Tuetuopay/stm32-usb-ble-devkit/README.md

# STM32 + nRF51 USB & BLE devkit

Small devkit to work with both USB and BLE. Useful for USB Bluetooth gadgets.
