Tuetuopay/stm32-usb-ble-devkit/pcb/stm32-usb-ble-devkit.brd

## EAGLE design pcb/stm32-usb-ble-devkit.brd (2018-11-05)

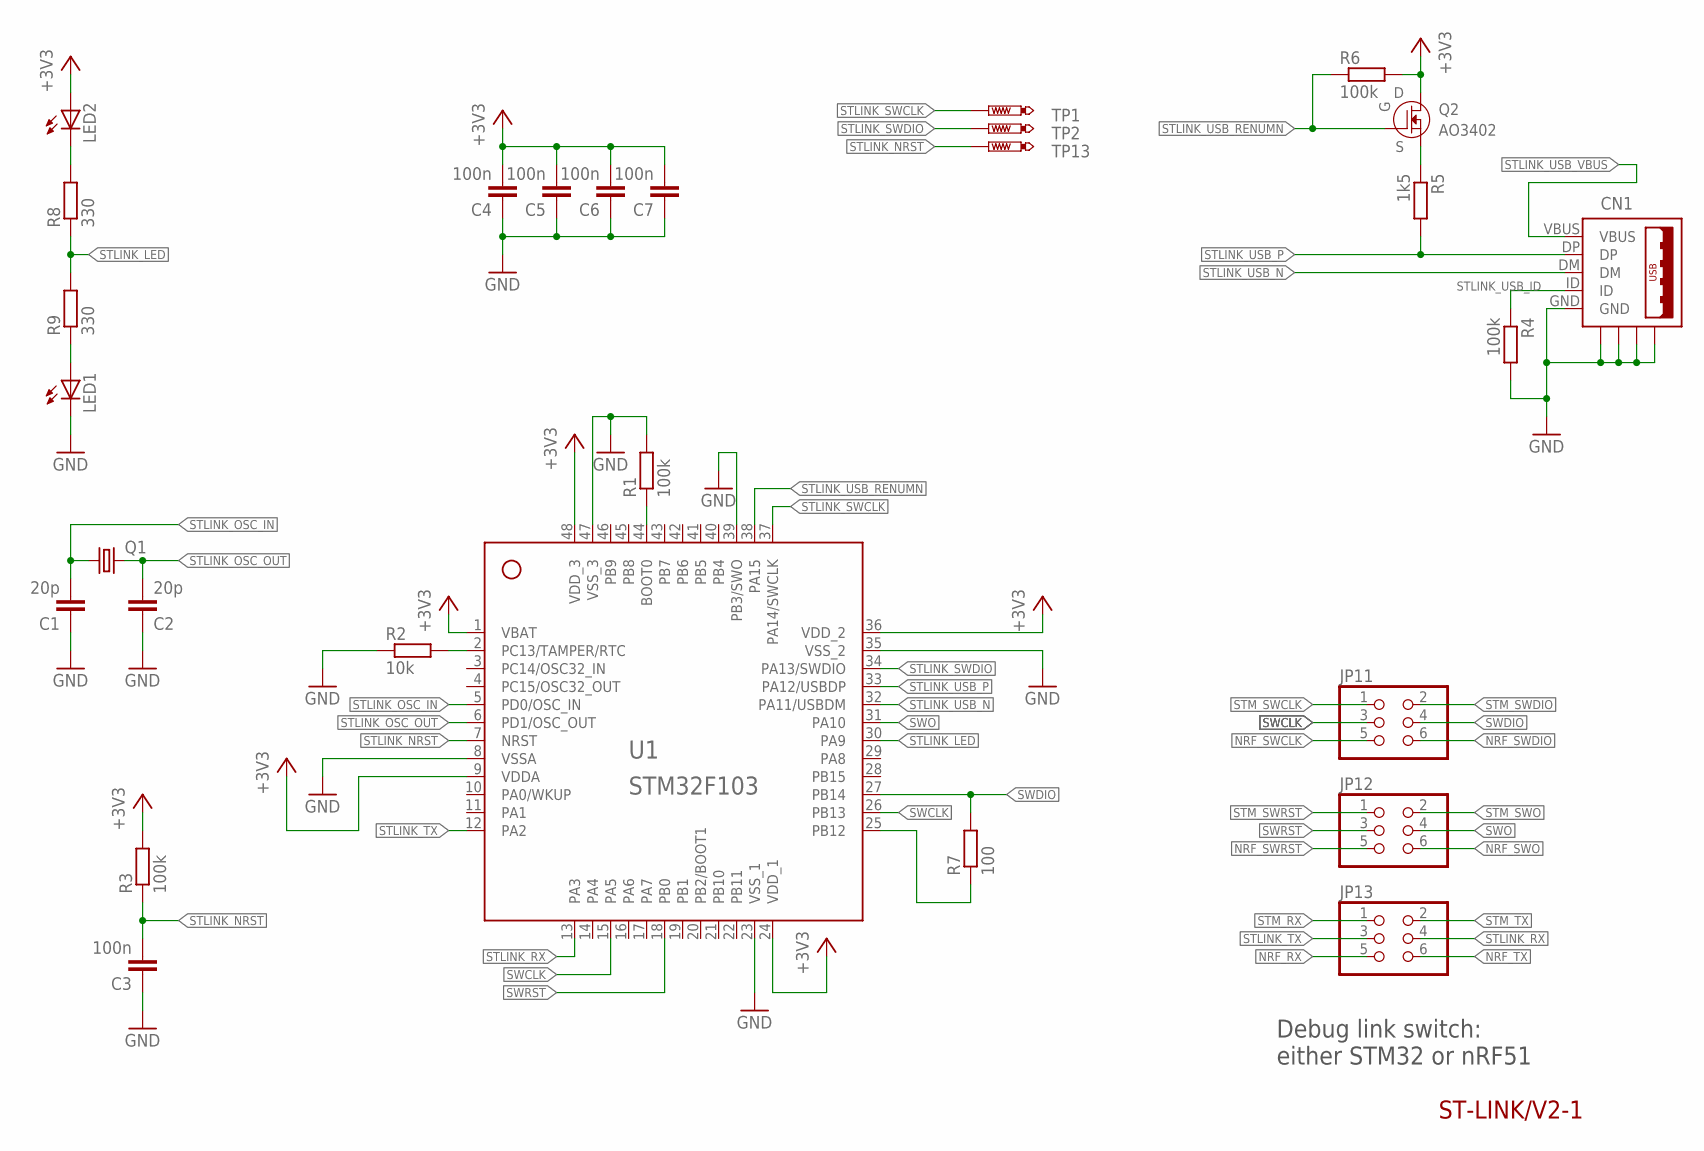
[picture p1: schematic stm32-usb-ble-devkit.sch, sheet 1]

Parts:
C1, C2: 20p; 0603
C3, C4, C5, C6, C7: 100n; 0603
CN1: USB-MICROB-2TABS; USB-MICROB-2
JP11, JP12, JP13: PINHD-2X3; 2X03
LED1, LED2: LEDCHIP-LED0603; CHIP-LED0603
Q1: CRYSTALHC49S; HC49/S
Q2: AO3402; SOT23-3
R1, R3, R4, R6: 100k; R0603
R2: 10k; R0603
R5: 1k5; R0603
R7: 100; R0603
R8, R9: 330; R0603
TP1, TP2, TP13: PTR1B1,27; B1,27
U1: STM32F103-48LQFP; LQFP-48

Connections:
+3V3: C4.2, C5.2, C6.2, C7.2, LED2.A, Q2.3 (D), R3.2, R6.2, U1.1 (VBAT), U1.9 (VDDA), U1.24 (VDD_1), U1.36 (VDD_2), U1.48 (VDD_3); also elsewhere on the board
GND: C1.1, C2.1, C3.1, C4.1, C5.1, C6.1, C7.1, CN1.GND, CN1.GND@1 (GND), CN1.GND@2 (GND), CN1.GND@3 (GND), CN1.GND@4 (GND), LED1.C, R1.2, R2.1, R4.2, U1.8 (VSSA), U1.23 (VSS_1), U1.35 (VSS_2), U1.39 (PB3/SWO), U1.47 (VSS_3); also elsewhere on the board
NRF_RX: JP13.5; also elsewhere on the board
NRF_SWCLK: JP11.5; also elsewhere on the board
NRF_SWDIO: JP11.6; also elsewhere on the board
NRF_SWO: JP12.6
NRF_SWRST: JP12.5
NRF_TX: JP13.6; also elsewhere on the board
STLINK_BOOT0: R1.1, U1.44 (BOOT0)
STLINK_LED: R8.1, R9.2, U1.30 (PA9)
STLINK_LED_RB: LED1.A, R9.1
STLINK_LED_RT: LED2.C, R8.2
STLINK_NRST: C3.2, R3.1, TP13.TP, U1.7 (NRST)
STLINK_OSC_IN: C1.2, Q1.1, U1.5 (PD0/OSC_IN)
STLINK_OSC_OUT: C2.2, Q1.2, U1.6 (PD1/OSC_OUT)
STLINK_PC13: R2.2, U1.2 (PC13/TAMPER/RTC)
STLINK_RX: JP13.4, U1.13 (PA3)
STLINK_SWCLK: TP1.TP, U1.37 (PA14/SWCLK)
STLINK_SWDIO: TP2.TP, U1.34 (PA13/SWDIO)
STLINK_SWDIO_PD: R7.1, U1.25 (PB12)
STLINK_TX: JP13.3, U1.12 (PA2)
STLINK_USB_ID: CN1.ID, R4.1
STLINK_USB_N: CN1.DM, U1.32 (PA11/USBDM)
STLINK_USB_P: CN1.DP, R5.2, U1.33 (PA12/USBDP)
STLINK_USB_RENUMN: Q2.1 (G), R6.1, U1.38 (PA15)
STLINK_USB_RENUM_PU: Q2.2 (S), R5.1
STLINK_USB_VBUS: CN1.VBUS; also elsewhere on the board
STM_RX: JP13.1; also elsewhere on the board
STM_SWCLK: JP11.1; also elsewhere on the board
STM_SWDIO: JP11.2; also elsewhere on the board
STM_SWO: JP12.2; also elsewhere on the board
STM_SWRST: JP12.1; also elsewhere on the board
STM_TX: JP13.2; also elsewhere on the board
SWCLK: JP11.3, U1.15 (PA5), U1.26 (PB13)
SWDIO: JP11.4, R7.2, U1.27 (PB14)
SWO: JP12.4, U1.31 (PA10)
SWRST: JP12.3, U1.18 (PB0)

Notes on the sheet:
ST-LINK/V2-1
Debug link switch: either STM32 or nRF51

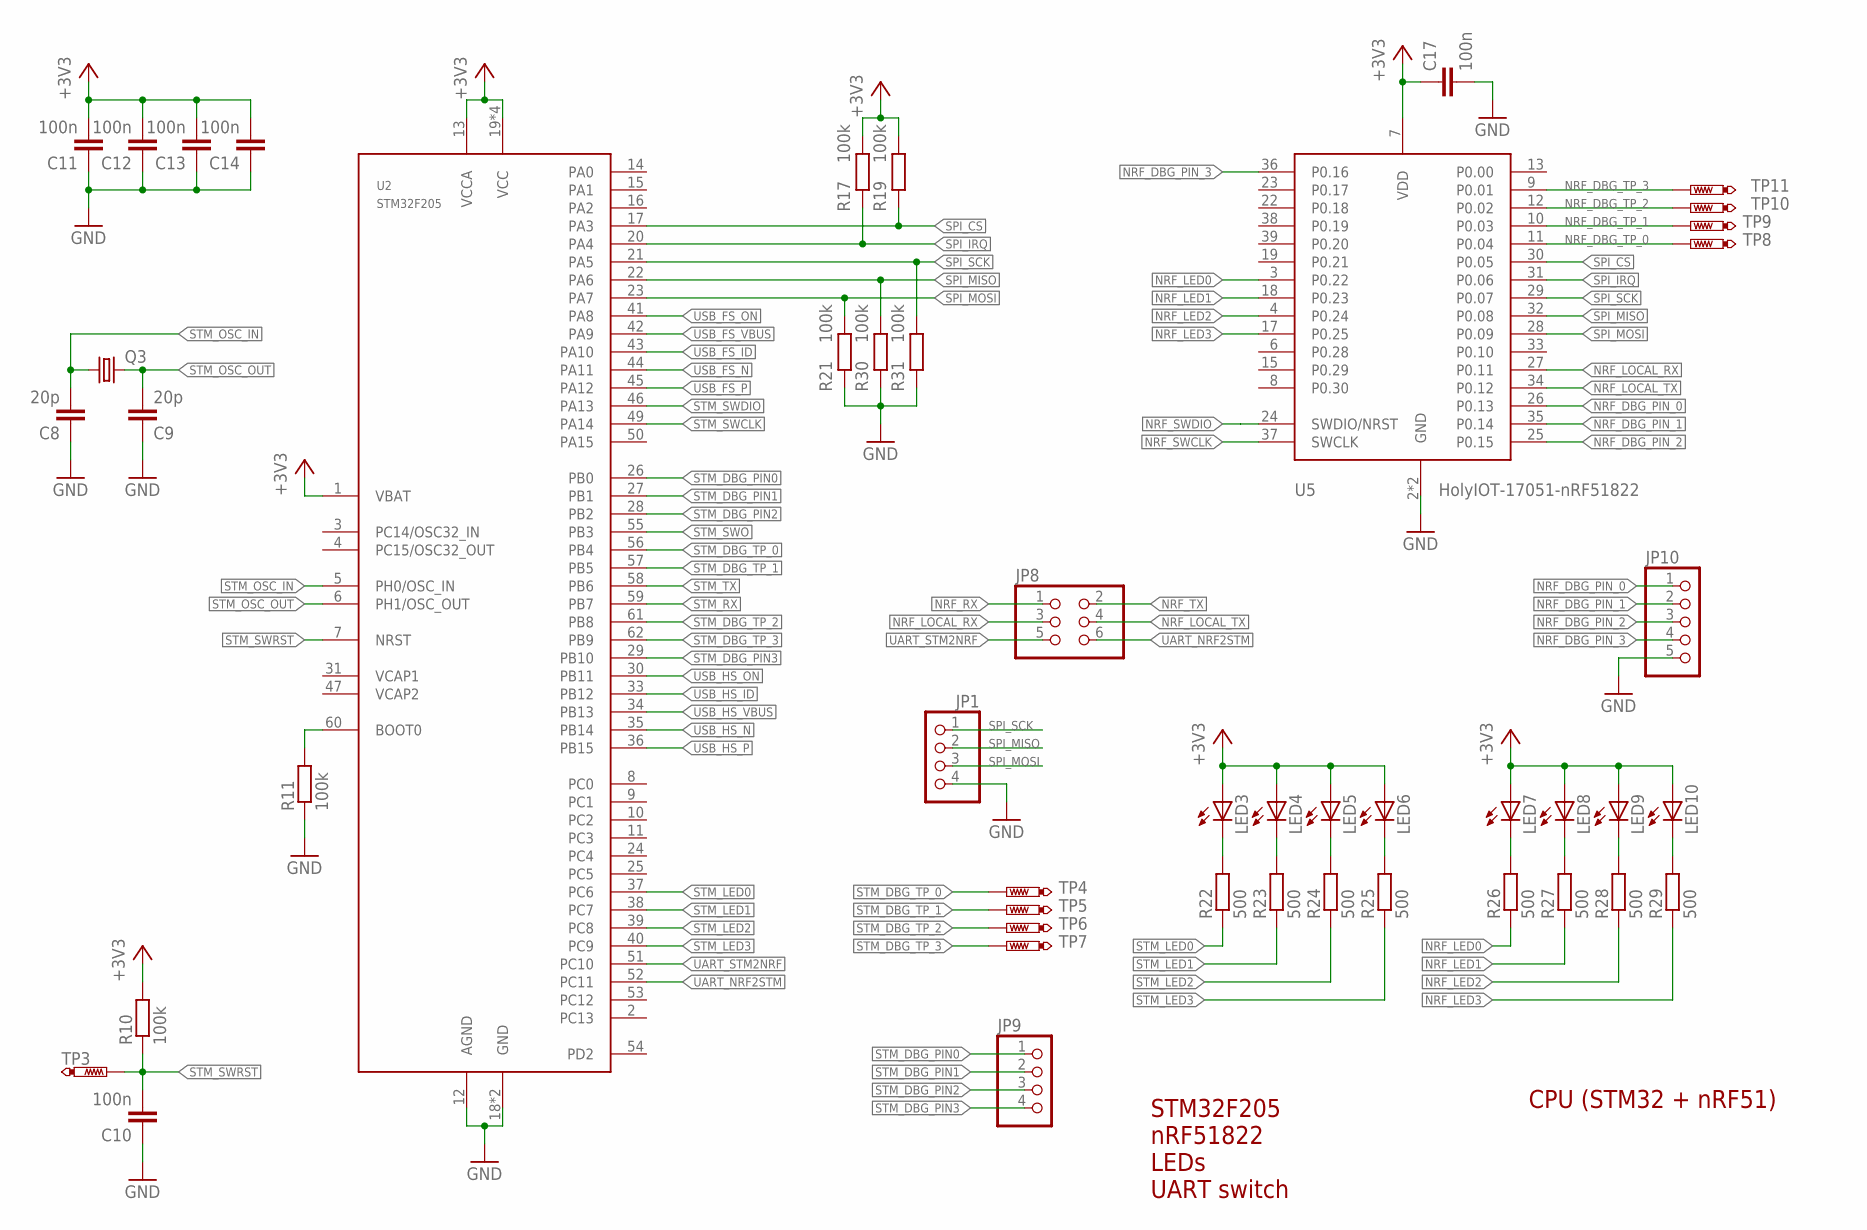
[picture p2: schematic stm32-usb-ble-devkit.sch, sheet 2]

Parts:
C8, C9: 20p; 0603
C10, C11, C12, C13, C14, C17: 100n; 0603
JP1, JP9: PINHD-1X4; 1X04
JP8: PINHD-2X3; 2X03
JP10: PINHD-1X5; 1X05
LED3, LED4, LED5, LED6, LED7, LED8, LED9, LED10: LEDCHIP-LED0603; CHIP-LED0603
Q3: CRYSTALHC49S; HC49/S
R10, R11, R17, R19, R21, R30, R31: 100k; R0603
R22, R23, R24, R25, R26, R27, R28, R29: 500; R0603
TP3, TP4, TP5, TP6, TP7, TP8, TP9, TP10, TP11: PTR1B1,27; B1,27
U2: STM32F205-64; LQFP-64
U5: HOLYIOT-17051-NRF51822

Connections:
+3V3: C11.2, C12.2, C13.2, C14.2, C17.1, LED3.A, LED4.A, LED5.A, LED6.A, LED7.A, LED8.A, LED9.A, LED10.A, R10.2, R17.2, R19.2, U2.1 (VBAT), U2.13 (VCCA), U2.19 (VCC), U2.32 (VCC), U2.48 (VCC), U2.64 (VCC), U5.7 (VDD); also elsewhere on the board
BOOT0: R11.2, U2.60 (BOOT0)
GND: C8.1, C9.1, C10.1, C11.1, C12.1, C13.1, C14.1, C17.2, JP1.4, JP10.5, R11.1, R21.1, R30.1, R31.1, U2.12 (AGND), U2.18 (GND), U2.63 (GND), U5.2 (GND), U5.14 (GND); also elsewhere on the board
NRF_DBG_PIN_0: JP10.1, U5.26 (P0.13)
NRF_DBG_PIN_1: JP10.2, U5.35 (P0.14)
NRF_DBG_PIN_2: JP10.3, U5.25 (P0.15)
NRF_DBG_PIN_3: JP10.4, U5.36 (P0.16)
NRF_DBG_TP_0: TP8.TP, U5.11 (P0.04)
NRF_DBG_TP_1: TP9.TP, U5.10 (P0.03)
NRF_DBG_TP_2: TP10.TP, U5.12 (P0.02)
NRF_DBG_TP_3: TP11.TP, U5.9 (P0.01)
NRF_LED0: R26.1, U5.3 (P0.22)
NRF_LED1: R27.1, U5.18 (P0.23)
NRF_LED2: R28.1, U5.4 (P0.24)
NRF_LED3: R29.1, U5.17 (P0.25)
NRF_LEDR0: LED7.C, R26.2
NRF_LEDR1: LED8.C, R27.2
NRF_LEDR2: LED9.C, R28.2
NRF_LEDR3: LED10.C, R29.2
NRF_LOCAL_RX: JP8.3, U5.27 (P0.11)
NRF_LOCAL_TX: JP8.4, U5.34 (P0.12)
NRF_RX: JP8.1; also elsewhere on the board
NRF_SWCLK: U5.37 (SWCLK); also elsewhere on the board
NRF_SWDIO: U5.24 (SWDIO/NRST); also elsewhere on the board
NRF_TX: JP8.2; also elsewhere on the board
SPI_CS: R19.1, U2.17 (PA3), U5.30 (P0.05)
SPI_IRQ: R17.1, U2.20 (PA4), U5.31 (P0.06)
SPI_MISO: JP1.2, R30.2, U2.22 (PA6), U5.32 (P0.08)
SPI_MOSI: JP1.3, R21.2, U2.23 (PA7), U5.28 (P0.09)
SPI_SCK: JP1.1, R31.2, U2.21 (PA5), U5.29 (P0.07)
STM_DBG_PIN0: JP9.1, U2.26 (PB0)
STM_DBG_PIN1: JP9.2, U2.27 (PB1)
STM_DBG_PIN2: JP9.3, U2.28 (PB2)
STM_DBG_PIN3: JP9.4, U2.29 (PB10)
STM_DBG_TP_0: TP4.TP, U2.56 (PB4)
STM_DBG_TP_1: TP5.TP, U2.57 (PB5)
STM_DBG_TP_2: TP6.TP, U2.61 (PB8)
STM_DBG_TP_3: TP7.TP, U2.62 (PB9)
STM_LED0: R22.1, U2.37 (PC6)
STM_LED1: R23.1, U2.38 (PC7)
STM_LED2: R24.1, U2.39 (PC8)
STM_LED3: R25.1, U2.40 (PC9)
STM_LEDR0: LED3.C, R22.2
STM_LEDR1: LED4.C, R23.2
STM_LEDR3: LED6.C, R25.2
STM_LEDR_2: LED5.C, R24.2
STM_OSC_IN: C8.2, Q3.1, U2.5 (PH0/OSC_IN)
STM_OSC_OUT: C9.2, Q3.2, U2.6 (PH1/OSC_OUT)
STM_RX: U2.59 (PB7); also elsewhere on the board
STM_SWCLK: U2.49 (PA14); also elsewhere on the board
STM_SWDIO: U2.46 (PA13); also elsewhere on the board
STM_SWO: U2.55 (PB3); also elsewhere on the board
STM_SWRST: C10.2, R10.1, TP3.TP, U2.7 (NRST); also elsewhere on the board
STM_TX: U2.58 (PB6); also elsewhere on the board
UART_NRF2STM: JP8.6, U2.52 (PC11)
UART_STM2NRF: JP8.5, U2.51 (PC10)
USB_FS_ID: U2.43 (PA10); also elsewhere on the board
USB_FS_N: U2.44 (PA11); also elsewhere on the board
USB_FS_ON: U2.41 (PA8); also elsewhere on the board
USB_FS_P: U2.45 (PA12); also elsewhere on the board
USB_FS_VBUS: U2.42 (PA9); also elsewhere on the board
USB_HS_ID: U2.33 (PB12); also elsewhere on the board
USB_HS_N: U2.35 (PB14); also elsewhere on the board
USB_HS_ON: U2.30 (PB11); also elsewhere on the board
USB_HS_P: U2.36 (PB15); also elsewhere on the board
USB_HS_VBUS: U2.34 (PB13); also elsewhere on the board

Notes on the sheet:
CPU (STM32 + nRF51)
STM32F205 nRF51822 LEDs UART switch

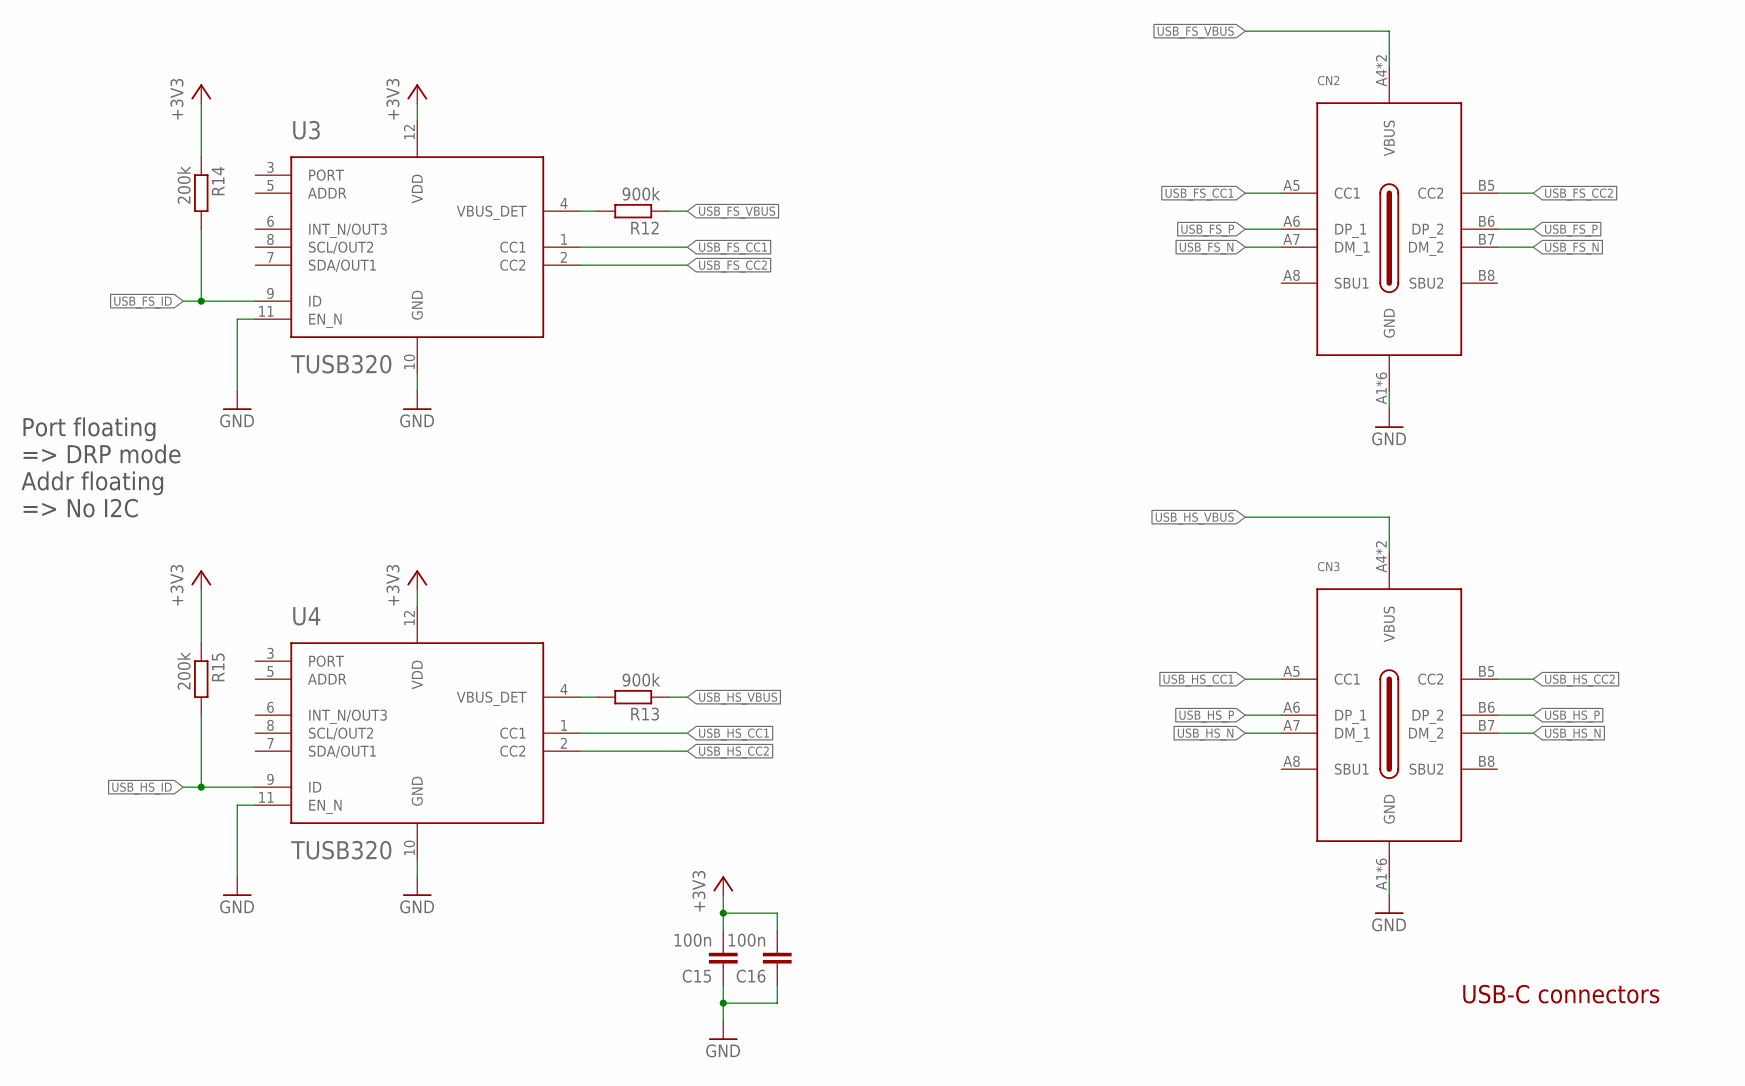
[picture p3: schematic stm32-usb-ble-devkit.sch, sheet 3]

Parts:
C15, C16: 100n; 0603
CN2, CN3: USB-C-2.0-FEMALE; USB-C-FEMALE
R12, R13: 900k; R0603
R14, R15: 200k; R0603
U3, U4: TUSB320; X2QFN-0.4

Connections:
+3V3: C15.2, C16.2, R14.1, R15.1, U3.12 (VDD), U4.12 (VDD); also elsewhere on the board
GND: C15.1, C16.1, CN2.A1 (GND), CN2.A12 (GND), CN2.G1 (GND), CN2.G2 (GND), CN2.G3 (GND), CN2.G4 (GND), CN3.A1 (GND), CN3.A12 (GND), CN3.G1 (GND), CN3.G2 (GND), CN3.G3 (GND), CN3.G4 (GND), U3.10 (GND), U3.11 (EN_N), U4.10 (GND), U4.11 (EN_N); also elsewhere on the board
USB_FS_CC1: CN2.A5 (CC1), U3.1 (CC1)
USB_FS_CC2: CN2.B5 (CC2), U3.2 (CC2)
USB_FS_ID: R14.2, U3.9 (ID); also elsewhere on the board
USB_FS_N: CN2.A7 (DM_1), CN2.B7 (DM_2); also elsewhere on the board
USB_FS_P: CN2.A6 (DP_1), CN2.B6 (DP_2); also elsewhere on the board
USB_FS_VBUS: CN2.A4 (VBUS), CN2.A9 (VBUS), R12.1; also elsewhere on the board
USB_FS_VBUS_DET: R12.2, U3.4 (VBUS_DET)
USB_HS_CC1: CN3.A5 (CC1), U4.1 (CC1)
USB_HS_CC2: CN3.B5 (CC2), U4.2 (CC2)
USB_HS_ID: R15.2, U4.9 (ID); also elsewhere on the board
USB_HS_N: CN3.A7 (DM_1), CN3.B7 (DM_2); also elsewhere on the board
USB_HS_P: CN3.A6 (DP_1), CN3.B6 (DP_2); also elsewhere on the board
USB_HS_VBUS: CN3.A4 (VBUS), CN3.A9 (VBUS), R13.1; also elsewhere on the board
USB_HS_VBUS_DET: R13.2, U4.4 (VBUS_DET)

Notes on the sheet:
Port floating => DRP mode Addr floating => No I2C
USB-C connectors

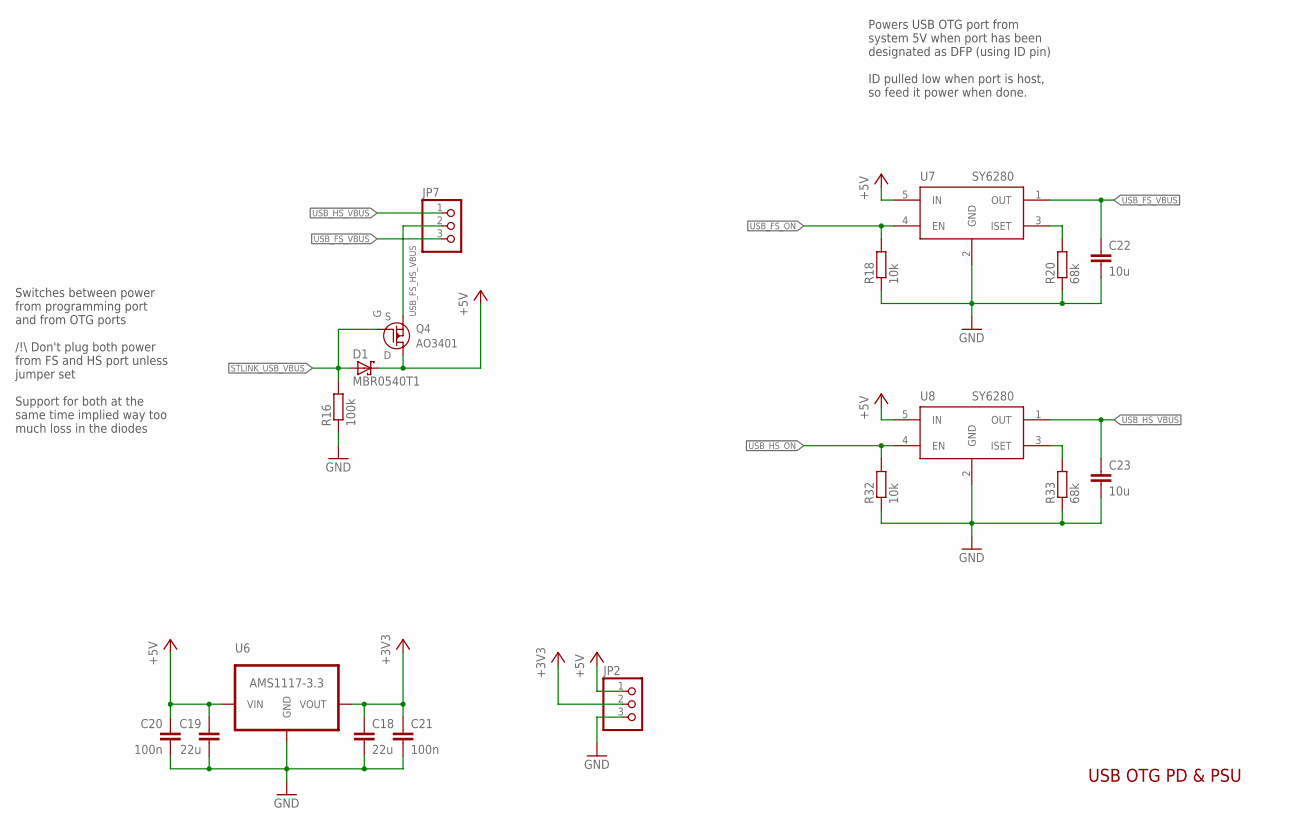
[picture p4: schematic stm32-usb-ble-devkit.sch, sheet 4]

Parts:
C18, C19: 22u; 0603
C20, C21: 100n; 0603
C22, C23: 10u; 0603
D1: MBR0540T1; SOD123
JP2, JP7: PINHD-1X3; 1X03
Q4: AO3401; SOT23-3
R16: 100k; R0603
R18, R32: 10k; R0603
R20, R33: 68k; R0603
U6: AMS1117-3.3; SOT223
U7, U8: SY6280; SOT23-5

Connections:
+3V3: C18.1, C21.1, JP2.2, U6.2 (VOUT); also elsewhere on the board
+5V: C19.1, C20.1, D1.C, JP2.1, Q4.3 (D), U6.3 (VIN), U7.5 (IN), U8.5 (IN)
GND: C18.2, C19.2, C20.2, C21.2, C22.2, C23.2, JP2.3, R16.1, R18.1, R20.1, R32.1, R33.1, U6.1 (GND), U7.2 (GND), U8.2 (GND); also elsewhere on the board
STLINK_USB_VBUS: D1.A, Q4.1 (G), R16.2; also elsewhere on the board
USB_FS_HS_VBUS: JP7.2, Q4.2 (S)
USB_FS_ISET: R20.2, U7.3 (ISET)
USB_FS_ON: R18.2, U7.4 (EN); also elsewhere on the board
USB_FS_VBUS: C22.1, JP7.3, U7.1 (OUT); also elsewhere on the board
USB_HS_ISET: R33.2, U8.3 (ISET)
USB_HS_ON: R32.2, U8.4 (EN); also elsewhere on the board
USB_HS_VBUS: C23.1, JP7.1, U8.1 (OUT); also elsewhere on the board

Notes on the sheet:
USB OTG PD & PSU
Switches between power from programming port and from OTG ports /\!\\ Don't plug both power from FS and HS port unless jumper set Support for both at the same time implied way too much loss in the diodes
Powers USB OTG port from system 5V when port has been designated as DFP (using ID pin) ID pulled low when port is host, so feed it power when done.

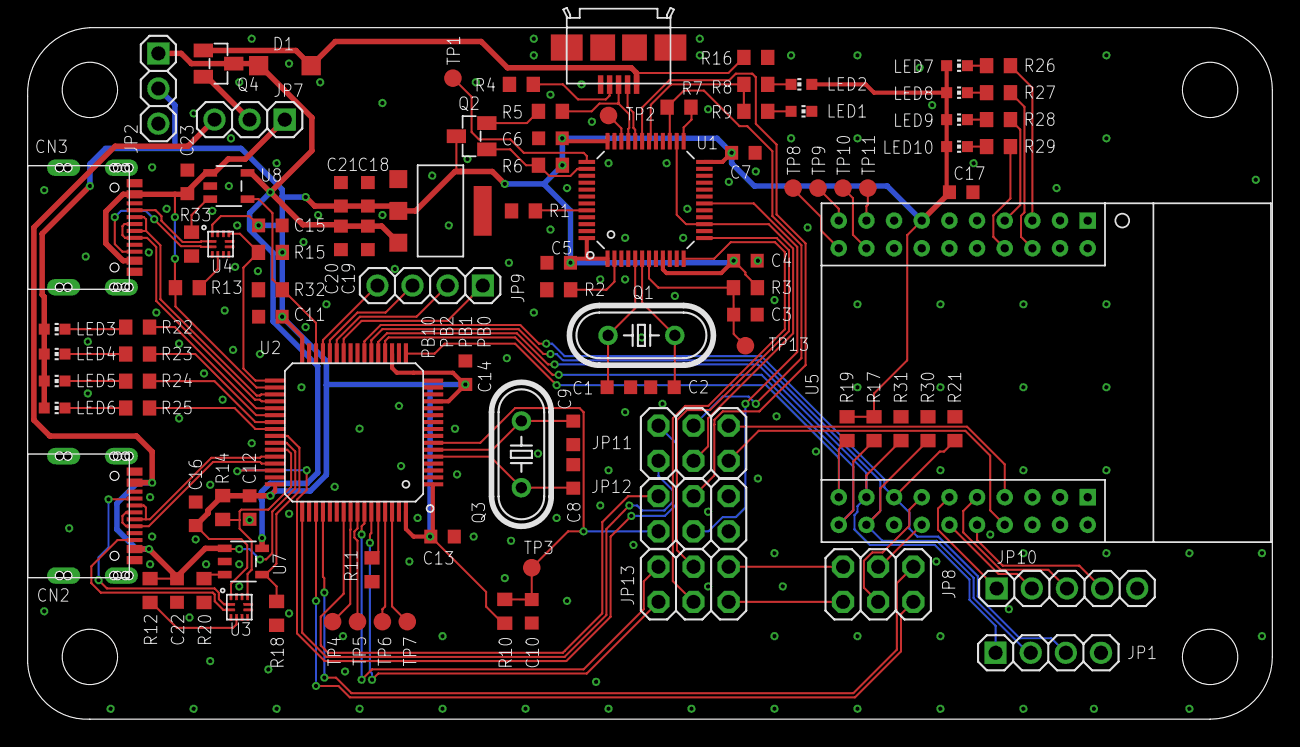
[picture p5: board stm32-usb-ble-devkit.brd from above]

Board: 2 copper layers, 90.0 x 50.0 mm, 103 parts (0 on the bottom side), 99 nets.
