Tuetuopay/stm32-usb-ble-devkit/firmware/stm32/src/usb/host.h

#ifndef _USB_HOST_H
#define _USB_HOST_H

/**
 * Initializes the USB host driver on both USB HS and USB FS.
 */
void usbHostInit(void);

/**
 * Starts the host driver on either FS or HS
 * @param isFs     true for USB FS, false for USB HS
 */
void usbHostStart(bool isFs);

/**
 * Stops the host driver on either FS or HS
 * @param isFs     true for USB FS, false for USB HS
 */
void usbHostStop(bool isFs);

/**
 * Sends a host report (OUT) to all devices
 * @param buf      report buffer
 * @param n        report buffer size
 */
void usbHostWriteReport(uint8_t *buf, size_t size);

#endif
