Tuetuopay/stm32-usb-ble-devkit/(commit log)

2018-09-04 Add schematic first shot
    [stm32-usb-ble-devkit.sch]
2018-09-04 Add PCB first shot
    [stm32-usb-ble-devkit.brd]
2018-09-05 pcb: Update USB-C connector footprint
    [stm32-usb-ble-devkit.sch]
2018-09-05 pcb: Finish routing (including 3v3 and 5v)
    [stm32-usb-ble-devkit.brd]
2018-09-05 pcb: Unhide GND airwires
    [stm32-usb-ble-devkit.brd]
2018-09-05 pcb: Fix symbol orientation and add PSU caps
    [stm32-usb-ble-devkit.brd, stm32-usb-ble-devkit.sch]
2018-09-05 pcb: Done groundplane
    [stm32-usb-ble-devkit.brd]
2018-09-06 pcb: Add proper CAM settings
2018-09-06 pcb: Add SPI PU/PD resistors
    [stm32-usb-ble-devkit.brd, stm32-usb-ble-devkit.sch]
2018-09-06 pcb: Approve resistor keepout DRC violations
    I don't plan to assemble this board with a pick and place, which those
    keepouts are made for.
    [stm32-usb-ble-devkit.brd]
2018-09-06 pcb: Add Makefile to easily generate output files
2018-09-07 pcb: Fix GND thermals size
    [stm32-usb-ble-devkit.brd]
2018-09-08 pcb: Add more GND vias
    [stm32-usb-ble-devkit.brd]
2018-09-15 Fix via size (6mm diam instead of 9)
    [stm32-usb-ble-devkit.brd]
2018-10-27 pcb: Make USB-C pads stick out more from the footprint
    [stm32-usb-ble-devkit.brd, stm32-usb-ble-devkit.sch]
2018-10-27 pcb: Fix ST-LINK BOOT0 resistor
    [stm32-usb-ble-devkit.brd, stm32-usb-ble-devkit.sch]
2018-10-27 pcb: Fix corner hole sizes (proper M4)
    [stm32-usb-ble-devkit.brd]
2018-10-27 pcb: Fix STM32 VCAP pins
    [stm32-usb-ble-devkit.brd, stm32-usb-ble-devkit.sch]
2018-10-27 pcb: Misc changes following via size fix
    [stm32-usb-ble-devkit.brd]
2018-10-27 pcb: Add USB VBUS detection and USB BUS ON
    [stm32-usb-ble-devkit.brd, stm32-usb-ble-devkit.sch]
2018-10-27 pcb: Increased space between USB-C connectors
    [stm32-usb-ble-devkit.brd]
2018-10-27 pcb: Replaced PSU BAS16 with better diode
    [stm32-usb-ble-devkit.brd, stm32-usb-ble-devkit.sch]
2018-10-27 pcb: Replace PSU 0805 caps with 0603
    [stm32-usb-ble-devkit.brd, stm32-usb-ble-devkit.sch]
2018-10-27 pcb: Switch OTG PSU MOSFET to dedicated IC
    [stm32-usb-ble-devkit.brd, stm32-usb-ble-devkit.sch]
2018-10-27 pcb: Fix LQFP64 silkscreen
    [stm32-usb-ble-devkit.brd, stm32-usb-ble-devkit.sch]
2018-10-27 pcb: GND plane improvements
    [stm32-usb-ble-devkit.brd]
2018-10-28 pcb/Makefile: Fix typo
2018-10-28 pcb: Misc GND fixups
    [stm32-usb-ble-devkit.brd]
2018-10-28 pcb: Add Harold Bluetooth to bottom silkscreen
    [stm32-usb-ble-devkit.brd]
2018-10-28 pcb: Slightly shifted USB-HS up
    [stm32-usb-ble-devkit.brd]
2018-11-01 pcb: Switch headers to round pads
    [stm32-usb-ble-devkit.brd, stm32-usb-ble-devkit.sch]
2018-11-01 pcb: Moved all nRF TP to the same side
    [stm32-usb-ble-devkit.brd, stm32-usb-ble-devkit.sch]
2018-11-01 pcb: Add SPI header
    [stm32-usb-ble-devkit.brd, stm32-usb-ble-devkit.sch]
2018-11-01 pcb: Add header exposing supply voltages
    [stm32-usb-ble-devkit.brd, stm32-usb-ble-devkit.sch]
2018-11-01 pcb: Make all silkscreen text the same thickness
    [stm32-usb-ble-devkit.brd]
2018-11-03 fw: Add basic stm32 project (blinkenlights)
2018-11-05 pcb: Fix some GND antennas
    [stm32-usb-ble-devkit.brd]
2018-11-20 fw/stm32: Update board file to pcb-v1.1
2018-12-15 stm32: Move main to dedicated src folder
2018-12-15 stm32: Add logger class
2018-12-15 stm32: Upgrade to ChibiOS 18.2.x
2018-12-15 stm32: Make logger thread safe
2018-12-16 stm32/usb: Add arbiter to handle OTG transitions
2018-12-16 stm32/usb: Add host driver
    Dumps HID events to serial port
2018-12-16 stm32/usb/host: Fix ring buffer
    [host.c]
2018-12-16 stm32: Add US keyboard layout to log letters
2018-12-16 stm32/usb/arbiter: Simulate OTG event at boot
    This allows to get the initial state of OTG ports (e.g. bootup with
    something already plugged in, or being powered by an OTG port).
2018-12-16 CI: Switch to my ChibiOS fork
2018-12-19 stm32/usb: Add USB HID keyboard device
    This adds the USB configuration, enumeration, synchronization with
    keyboards plugged in, etc...
2018-12-19 stm32/usb/hid_dev_cfg: Cleanup test stuff
2018-12-19 stm32/usb/host: Sync keyboard LED state with internal one
